tudelft/t4_actuators_board/docs/images/serial_communication_servo.jpg

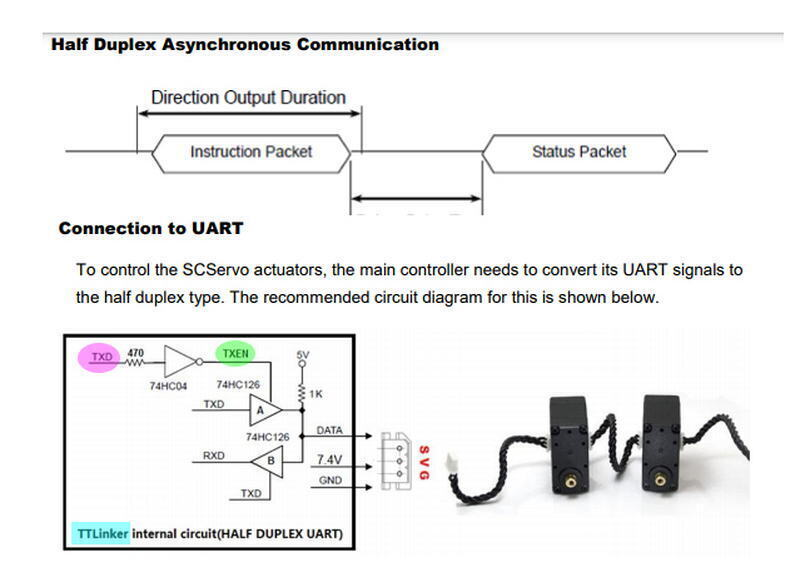
docs/images/serial_communication_servo.jpg
