tudelft/t4_actuators_board/docs/images/setservo_interface_example.jpg

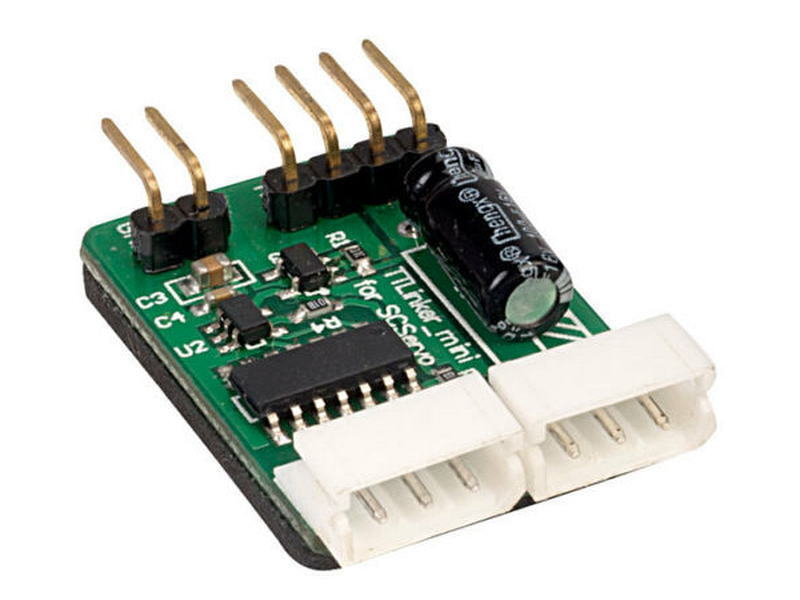
docs/images/setservo_interface_example.jpg
