tudelft/t4_actuators_board/docs/images/setservo_interface_schematic.jpg

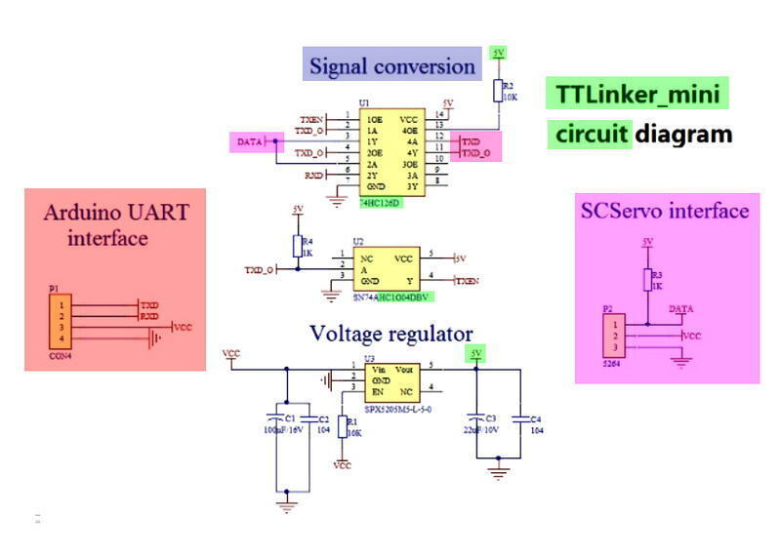
docs/images/setservo_interface_schematic.jpg
