tudelft/t4_actuators_board/docs/images/ti_sn_74ahc1g04_inverter_chip.jpg

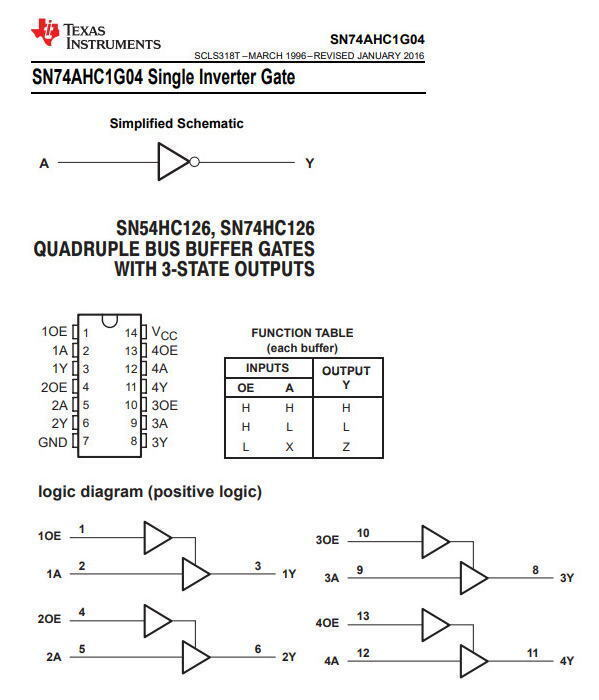
docs/images/ti_sn_74ahc1g04_inverter_chip.jpg
