tudelft/t4_actuators_board/hardware/Teensy_t4_module.PNG

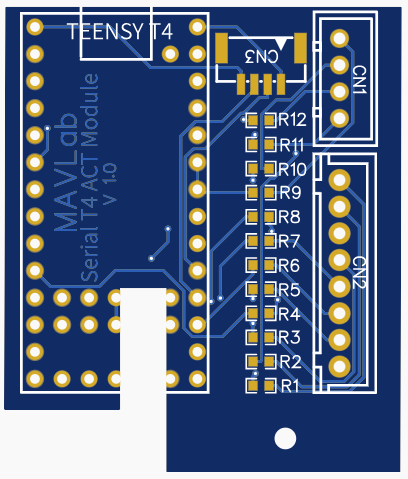
hardware/Teensy_t4_module.PNG
