tudelft/t4_actuators_board/(threads)

Thread 1 (2024-08-17):

About telemtry issue

SonglanWang, 2024-08-17:
Hi guys,

It's nice to see your achievement.

I meet some trouble with getting enough 10 bytes telemetry data from ESC. And I am not only using my own method but also tried using  jacqu's teensyshot source code. Both of them can't get enough 10 bytes telemertry.

So may I ask which version of the AM32 firmware is being used on your tests? My own version is AM32_SKYSTARS_KM55_E230_1.98.

Thanks in advance!

Closed 2024-09-05.
