tudelft/t4_actuators_board/(commit log)

2024-07-08 T4 Actuator Board kick-off
2024-07-12 Added gerber of the teensy board v1
2024-07-12 Added labels to PCB schematic
2024-09-12 Fixed power labels
2024-09-12 Further corrected schematics
2024-10-10 added feature on ESC 0
2024-10-17 Live recovery now possible at intermittent ESC signal loss
2025-11-12 Update firmware compilation instructions in README
    Added instructions for Arduino IDE version 1.59.0 and updated code snippet for ESCCMD_serial.
